anupam-dubey/hot-plate-reflow/README.MD

# Programmable Temperature Controller + Hot Plate 
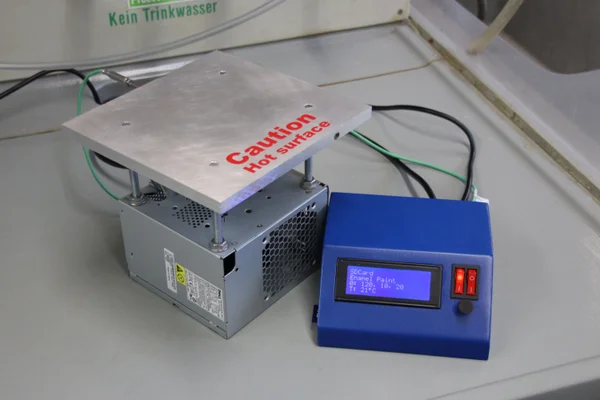
[picture p1: img4.jpg]


### Project uses atmega328 with triac
## Software on arduino
