anupam-dubey/hot-plate-reflow/im1.jpg

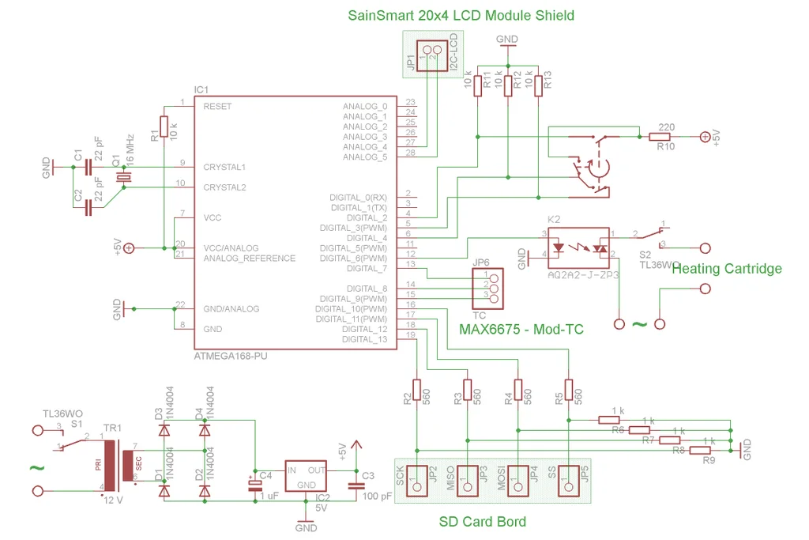
im1.jpg
